snupcb2018/PODFA/PODFA Monitor/img/20250901_171232.png

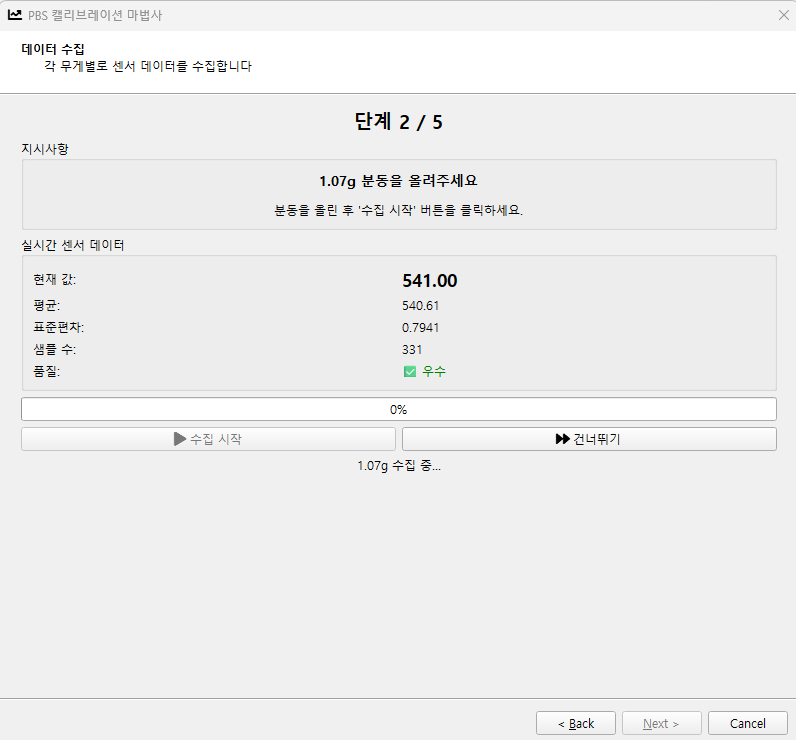
PODFA Monitor/img/20250901_171232.png
