snupcb2018/PODFA/PODFA Monitor/img/20250901_214229.png

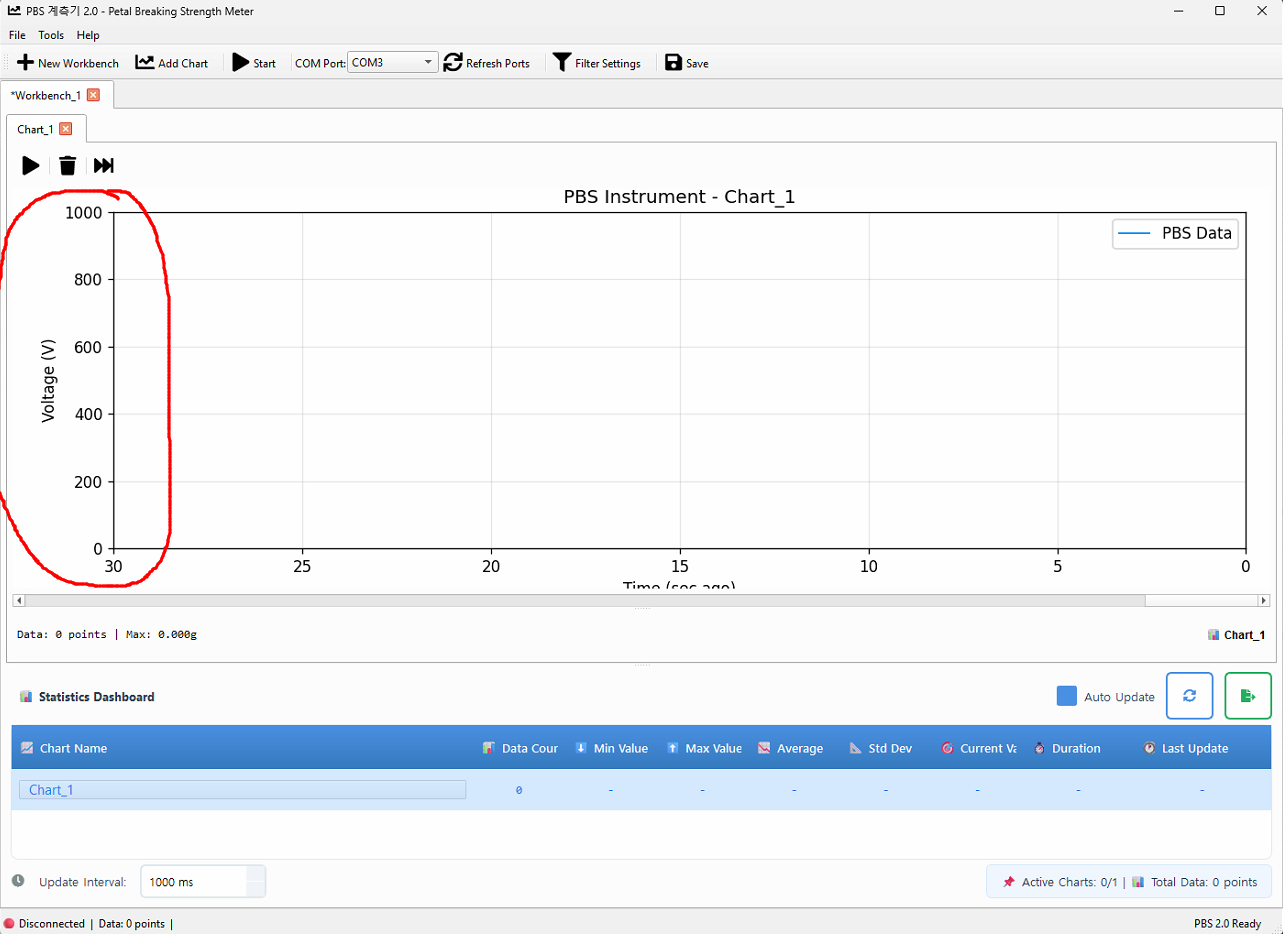
PODFA Monitor/img/20250901_214229.png
