snupcb2018/PODFA/PODFA Monitor/img/20250901_215451.png

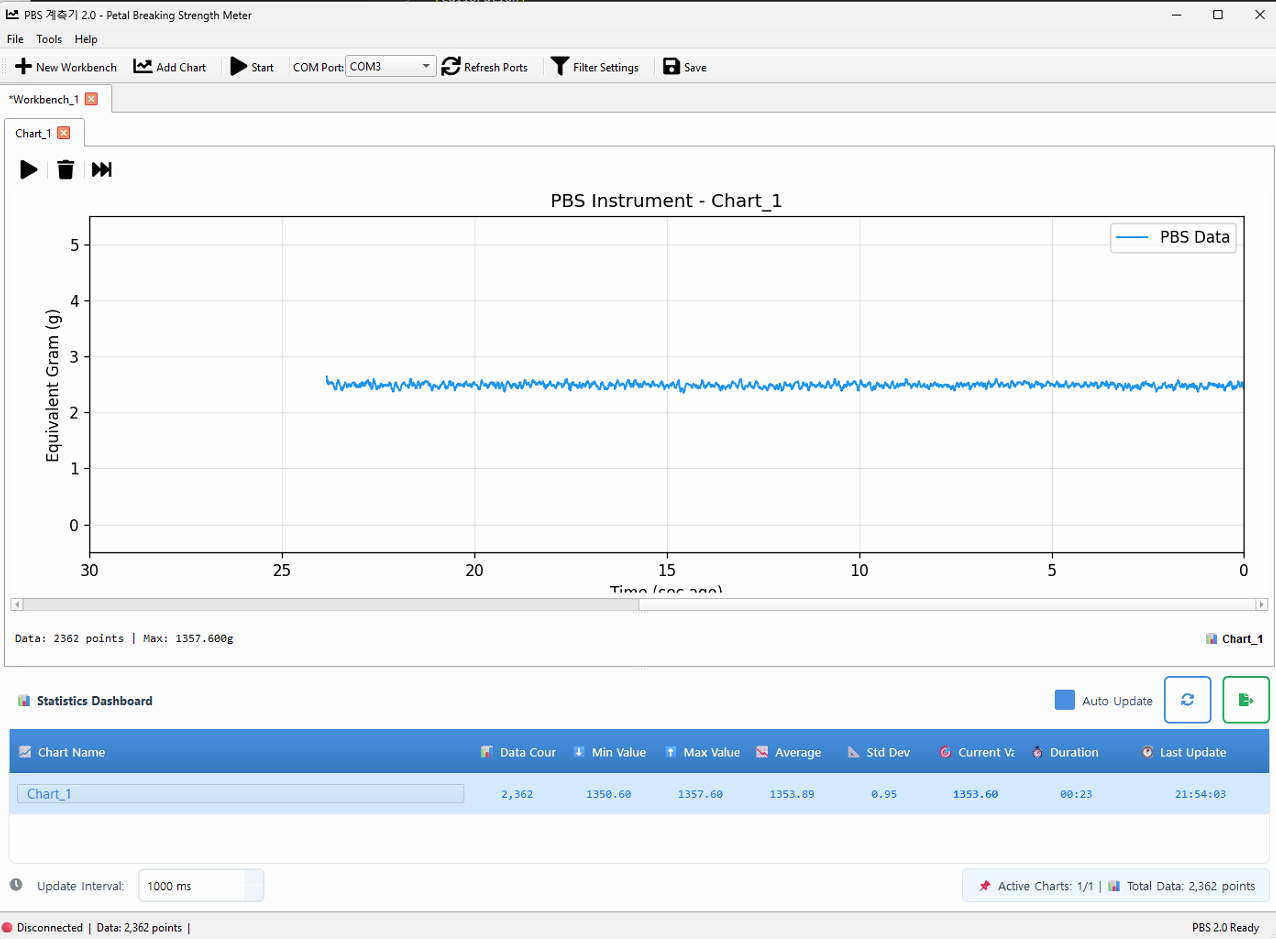
PODFA Monitor/img/20250901_215451.png
