snupcb2018/PODFA/RaspberryPi/main.py

import time
import platform
import os
import serial

# 환경 확인: Travis CI나 Linux가 아닌 환경에서 실행되지 않도록 함
try:
    if 'CI' in os.environ or platform.system() != 'Linux':
        raise ImportError()
    import Adafruit_GPIO.SPI as SPI
except ImportError:
    # 모의 SPI 클래스 생성
    class SPI(object):
        MSBFIRST = 1
        class SpiDev(object):
            def __init__(self, a, b, max_speed_hz): pass
            def transfer(self, a): return [0x7f] * len(a)
            def set_mode(self, a): pass
            def set_bit_order(self, a): pass
            def close(self): pass


class MCP3208(object):
    def __init__(self):
        self.spi = SPI.SpiDev(0, 0, max_speed_hz=1000000)
        self.spi.set_mode(0)
        self.spi.set_bit_order(SPI.MSBFIRST)

    def __del__(self):
        self.spi.close()

    def read(self, ch):
        if not (0 <= ch <= 7):
            raise Exception('MCP3208 channel must be 0-7: ' + str(ch))

        cmd = 128  # 1000 0000
        cmd += 64  # 1100 0000
        cmd += ((ch & 0x07) << 3)
        ret = self.spi.transfer([cmd, 0x0, 0x0])

        # get the 12b out of the return
        val = (ret[0] & 0x01) << 11  # only B11 is here
        val |= ret[1] << 3           # B10:B3
        val |= ret[2] >> 5           # MSB has B2:B0 ... need to move down to LSB

        return val & 0x0FFF  # ensure we are only sending 12b


# 직렬 통신 설정
ser = serial.Serial('/dev/ttyAMA0', 115200)
adc = MCP3208()

try:
    while True:
        # MCP3208의 채널 0 데이터를 읽음
        value = adc.read(0)
        print(f'value = {value}')
        # 데이터를 직렬 포트로 전송
        ser.write(f"{value}\n".encode('utf-8'))
        # 1초 대기
        time.sleep(0.5)
except KeyboardInterrupt:
    pass
finally:
    ser.close()
