snupcb2018/PODFA/(commit log)

2025-12-17 Add comprehensive README and hardware documentation
    - Add detailed README.md with complete reproducibility guide
    - Include PCB circuit diagrams (SVG) for signal processing and Z-stage control
    - Add Gerber files for JLCPCB PCB manufacturing
    - Include hardware assembly, installation, and calibration instructions
    Supports researchers in replicating the PODFA system for flower abscission studies.
2025-12-18 Update system architecture diagram with accurate independent system representation
    - Replace old diagram with new block diagram showing independent systems
    - Clarify tripod + MLT050 + nylon line + gripper structure
    - Show Z-stage as completely separate (no mechanical link)
    - Update Data Flow section to show two independent paths
    - Add detailed OPERATION steps and KEY POINTS explanation
2025-12-18 Translate Korean comments and docstrings to English
    Replace Korean text with English in:
    - core/calibration.py: CalibrationEngine, CalibrationMethod, CalibrationState, and related methods
    - main.py: PBS2Application and helper functions
    - ui/calibration/calibration_wizard.py: CalibrationSettings and wizard pages
    Also add .gitignore to exclude Python cache, logs, and user-specific settings.
    [calibration.py, main.py]
